vad7/FanCoilPower2/README.md

# FanCoilPower2
Доработка фанкойла Ballu BMFL-180M (270M/360M/...)

Подробно тут: http://vad-7.blogspot.com/2017/09/ballu-bmfl-180m.html
