vad7/FanCoilPower2/Case.stl

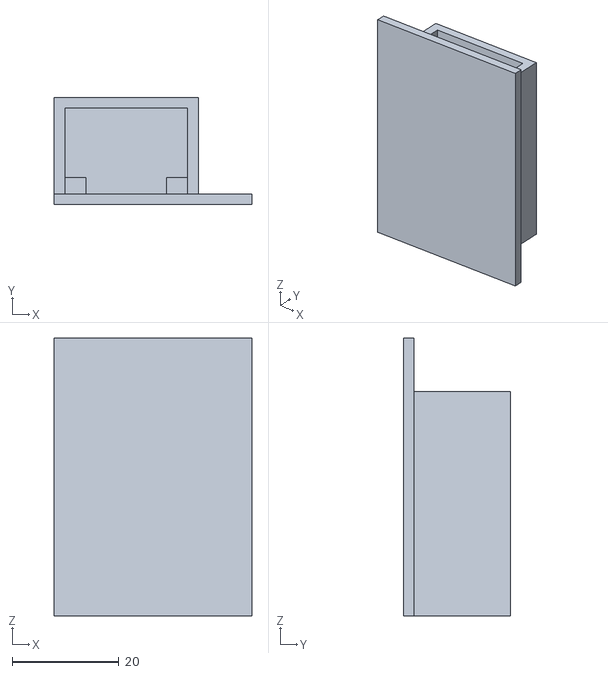
[picture p5: CAD file, 2021-01-22]
Case.stl
37.0 x 20.0 x 52.0
