vad7/FanCoilPower2/FanCoilPower.PDF

## PIPE

IC1

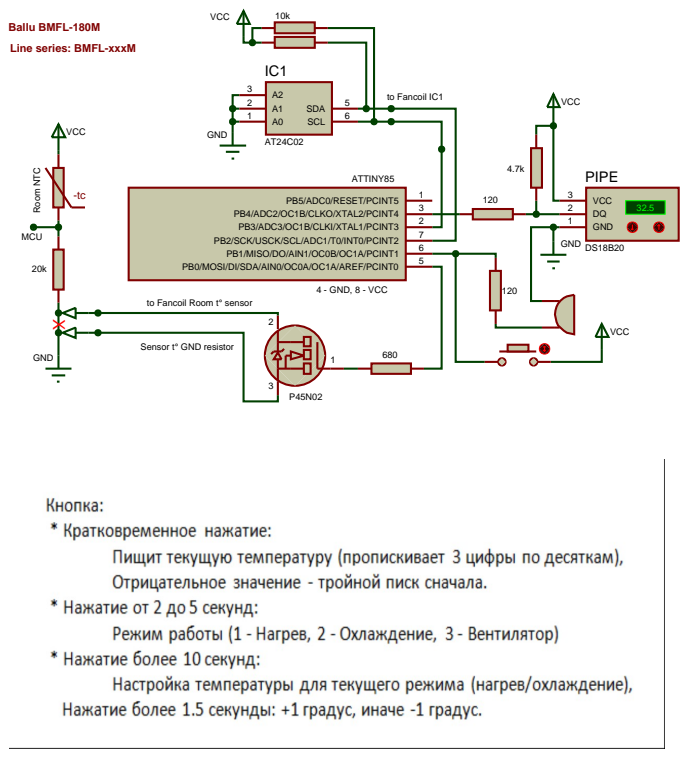
[picture p6: page 1]
to Fancoil IC1; MCU; VCC 3; GND 1; PB5/ADC0/RESET/PCINT5; PB3/ADC3/OC1B/CLKI/XTAL1/PCINT3; PB4/ADC2/OC1B/CLKO/XTAL2/PCINT4; PB2/SCK/USCK/SCL/ADC1/T0/INT0/PCINT2; PB1/MISO/DO/AIN1/OC0B/OC1A/PCINT1; PB0/MOSI/DI/SDA/AIN0/OC0A/OC1A/AREF/PCINT0; ATTINY85; 4 - GND, 8 - VCC; GND; VCC; SCL; SDA; Room NTC

Ballu BMFL-180M
Line series: BMFL-xxxM

to Fancoil Room t° sensor

Sensor t° GND resistor
